jrosmirez94/Pedal-Multiefecto/Imagenes/PCB.jpeg

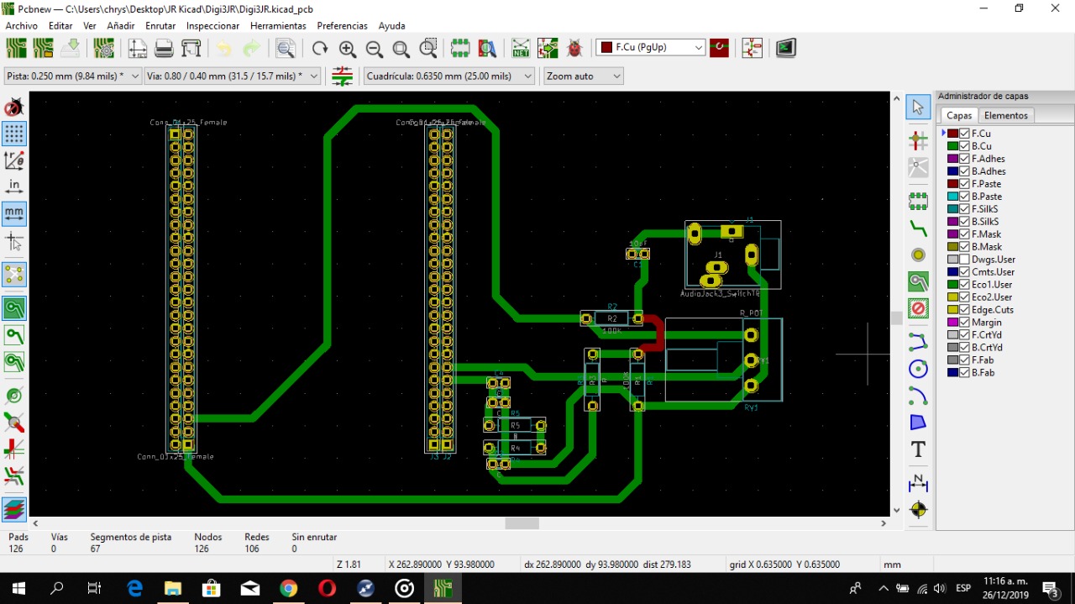
Imagenes/PCB.jpeg
