jrosmirez94/Pedal-Multiefecto/README.md

# Pedal-Multiefecto
Pedal Multiefecto para guitarra electrica (LoopBack, Delay, Fuzz y Wah-wah)
