jrosmirez94/Pedal-Multiefecto/Notas de clases/NOTAS CLASE 20200510.txt

CS43L22 DAC+amplificador de la discovery
que esta al lado del jack

este DAC es delta-sigma y el amplificador es clase D

Página 33 Control Port Operation
Datasheet

para mandar datos del micro al DAC, para enviarle los datos le tengo que indicar para quien es a traves del bus de datos, el adress fijo para comunicarme es "100101" 

La compilacion se basa en 3 pasos
	pre compiler
	compiler
	linker

-El pre compile hace un copy paste de los include agarra lo que hay en el ".h" y lo pega en el ".c"

-El compiler transforma cada ".c" en un ".o" 

-Linker toma todos los ".o" y genera el ejecutable

significa si que creas una variable global esa variable esta dentro de un ".o", si vos creas una variable con el mismo nombre en dos ".c" distintos, vas a tener dos .o distintos con la misma variable y el linker va a tirar un error para que eso no pase tenes que poner extern a una de esas variables, con eso le estas diciendo al linker que te LINKEE una variable con otra

EJEMPLO: extern I2C_HandleTypeDef hi2c1;

arranco a codear abajo de esto
|
|

/* USER CODE BEGIN 2 */

  /* USER CODE END 2 */

porque ya se inicializaron el clock 

HAL (hw abstration layer) es una libreria para que sea mas facil para el usuario codear

el hanlder es una instancia de una clase que tiene la configuracion del i2c

//HAL_GPIO_WritePin(LD6_GPIO_Port,LD6_Pin,1);
uint8_t data [2]; //necesito 2 bytes uno para el registro y otro para el dato que quiero poner en ese registro
data[0]=0x00; //registro
data[1]=0x99; //dato o valor
HAL_I2C_Master_Transmit(&hi2c1,0x94, data, 2, 50);
