jrosmirez94/Pedal-Multiefecto/Imagenes/Esquematico.jpeg

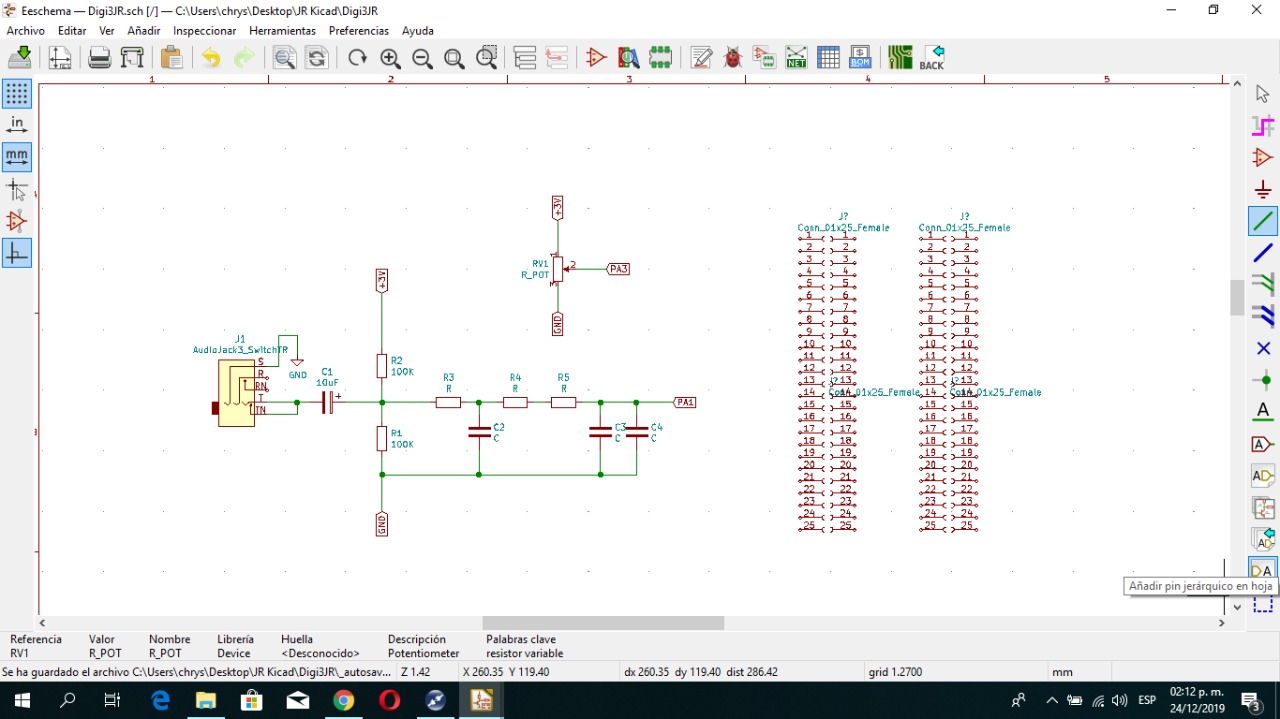
Imagenes/Esquematico.jpeg
