jrosmirez94/Pedal-Multiefecto/Imagenes/FSM effect - nivelacion y shift/FSM effect - nivelacion y shift/1 Nivelacion IN.jpg

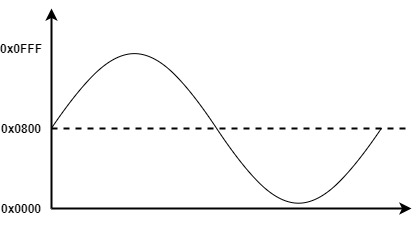
Imagenes/FSM effect - nivelacion y shift/FSM effect - nivelacion y shift/1 Nivelacion IN.jpg
