jrosmirez94/Pedal-Multiefecto/Imagenes/FSM effect - nivelacion y shift/FSM effect - nivelacion y shift/3 Shifteo nivelacion.jpg

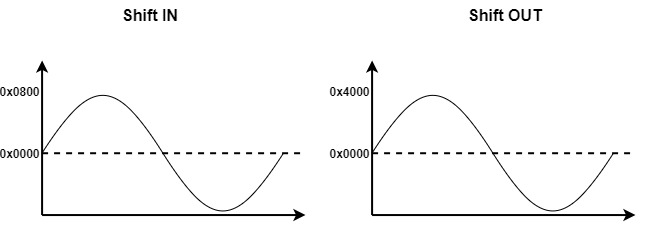
Imagenes/FSM effect - nivelacion y shift/FSM effect - nivelacion y shift/3 Shifteo nivelacion.jpg
