jrosmirez94/Pedal-Multiefecto/Pedal para guitarra - Jorge Rosmirez _v00/Pedal para guitarra - Jorge Rosmirez _v00.ioc

PD12.GPIO_Label=LD4 [Green Led]
PC12.Signal=I2S3_SD
PA14.GPIO_Label=SWCLK
PA6.GPIO_Label=SPI1_MISO [L3GD20_AS0/SDO]
PB6.GPIO_Label=Audio_SCL [CS43L22_SCL]
PC15-OSC32_OUT.GPIO_Label=PC15-OSC32_OUT
PD4.Signal=GPIO_Output
PB6.Signal=I2C1_SCL
PC7.Signal=I2S3_MCK
PC3.Signal=I2S2_SD
PE5.Signal=GPXTI5
PE1.Signal=GPXTI1
PE4.GPIO_Label=INT1 [LSM303DLHC_INT1]
PE2.Signal=GPIO_Input
PB9.Signal=I2C1_SDA
PD12.Signal=GPIO_Output
PA10.Signal=USB_OTG_FS_ID
PA4.GPIO_Label=I2S3_WS [CS43L22_LRCK]
PD15.Signal=GPIO_Output
PA9.GPIO_Label=VBUS_FS
PA11.GPIO_Label=OTG_FS_DM
PC0.Signal=GPIO_Output
PC14-OSC32_IN.Signal=RCC_OSC32_IN
PA0-WKUP.Signal=GPXTI0
PA9.Signal=USB_OTG_FS_VBUS
PB10.Signal=I2S2_CK
PA5.Signal=SPI1_SCK
PE1.GPIO_Label=MEMS_INT2 [L3GD20_INT2]
PC7.GPIO_Label=I2S3_MCK [CS43L22_MCLK]
PA4.Signal=I2S3_WS
PA5.GPIO_Label=SPI1_SCK [L3GD20_SC/SPC]
PE5.GPIO_Label=INT2 [LSM303DLHC_INT2]
PC12.GPIO_Label=I2S3_SD [CS43L22_SDIN]
PA11.Signal=USB_OTG_FS_DM
PE3.Signal=GPIO_Output
PC3.GPIO_Label=PDM_OUT [MP45DT02_DOUT]
Mcu.UserName=STM32F411VETx
PC10.Signal=I2S3_CK
PC0.GPIO_Label=OTG_FS_PowerSwitchOn
PD13.Signal=GPIO_Output
PA12.Signal=USB_OTG_FS_DP
PA10.GPIO_Label=OTG_FS_ID
PE4.Signal=GPXTI4
PD13.GPIO_Label=LD3 [Orange Led]
PA6.Signal=SPI1_MISO
PD5.GPIO_Label=OTG_FS_OverCurrent
PC14-OSC32_IN.GPIO_Label=PC14-OSC32_IN
PE2.GPIO_Label=DATA_Ready [LSM303DLHC_DRDY]
PA3.Signal=ADCx_IN3
PB3.GPIO_Label=SWO
PD15.GPIO_Label=LD6 [Blue Led]
PB9.GPIO_Label=Audio_SDA [CS43L22_SDA]
PC10.GPIO_Label=I2S3_SCK [CS43L22_SCLK]
PD5.Signal=GPIO_Input
PA12.GPIO_Label=OTG_FS_DP
PA13.Signal=SYS_JTMS-SWDIO
PB10.GPIO_Label=CLK_IN [MP45DT02_CLK]
PC15-OSC32_OUT.Signal=RCC_OSC32_OUT
PA1.Signal=ADCx_IN1
PD4.GPIO_Label=Audio_RST [CS43L22_RESET]
PD14.GPIO_Label=LD5 [Red Led]
PA13.GPIO_Label=SWDIO
PD14.Signal=GPIO_Output
PB3.Signal=SYS_JTDO-SWO
PA7.GPIO_Label=SPI1_MOSI [L3GD20_SDA/SDI/SDO]
PA14.Signal=SYS_JTCK-SWCLK
PE3.GPIO_Label=CS_I2C/SPI [L3GD20_CS_I2C/SPI]
PB12.Signal=I2S2_WS
PA7.Signal=SPI1_MOSI
