jrosmirez94/Pedal-Multiefecto/Pedal para guitarra - Jorge Rosmirez _v00/Src/audio.c

/******************************************************************************
 *  								INCLUDES
 ******************************************************************************/
// STM includes
#include "main.h"
#include "adc.h"
#include "i2c.h"
#include "i2s.h"
#include "stm32f4xx_it.h"
#include "arm_math.h"

// Project includes
#include "audio.h"
#include "CS43L22.h"

/******************************************************************************
 *  						GLOBAL VARIABLES DECLARATION
 ******************************************************************************/
DMA_FST_t transmit_ready = DMA_INIT;
q15_t * buffer_DMA = NULL; // puntero que apunta el vector con las muetras a ser procesadas

/******************************************************************************
 *  						LOCAL VARIABLES DECLARATION
 ******************************************************************************/
static q15_t   _dma_out   [DMA_HALF_SIZE * 2 * CHANNELS_OUT] = {0}; //salida
static q15_t   _dma_in    [DMA_HALF_SIZE * 2 * CHANNELS_IN] = {0}; //entrada
static q15_t   _dma_aux   [DMA_HALF_SIZE * 1 * CHANNELS_IN] = {0};
/******************************************************************************
 *  						GLOBAL FUNCTIONS DEFINITION
 ******************************************************************************/
void init_audio ()
{
	// Configura DAC
	CS43L22_init ();
	
	// Inicia Transmision de ADC y DAC (a traves de I2S) por DMA

	// DMA para mover del _dma_out al DAC
	HAL_I2S_Transmit_DMA (& hi2s3, (uint16_t *) _dma_out, DMA_HALF_SIZE * 2 * CHANNELS_OUT);
	HAL_Delay (1); // Must start I2S before ADC
	// DMA para mover del ADC al _dma_in
	HAL_ADC_Start_DMA (& hadc1, (uint32_t *) _dma_in, DMA_HALF_SIZE * 2 * CHANNELS_IN); // le doy el doble de capacidad con respecto al de salida porque tengo intercaladas las muetras del pote (es decir tengo 2 canales habilidados para el ADC)
}

/******************************************************************************
 *  						INTERRUPT HANDLERS
 ******************************************************************************/
// not use __disable_irq() and __enable_irq() to do critical stuffs
// put transmit_ready = HAL_TIMEOUT at finalize using buffer_DMA

//**ADC**//

void HAL_ADC_ConvHalfCpltCallback (ADC_HandleTypeDef * hadc)
{
	if (transmit_ready == DMA_LOGIC_BUSY) // indica que las muestras que tome del ADC no se procesaron, y esta tomando nuevas muestras y pisando información.
	{
	}
	else
	{			
		arm_shift_q15(&_dma_in[0],0,&_dma_aux[0],DMA_HALF_SIZE*CHANNELS_IN);
		buffer_DMA=&_dma_aux[0];
		transmit_ready = DMA_ADC_READY;		// hasta aca tengo la mitad del buffer lleno
	}
}

void HAL_ADC_ConvCpltCallback (ADC_HandleTypeDef * hadc)
{
	if (transmit_ready == DMA_LOGIC_BUSY)
	{
	}
	else
	{
		arm_shift_q15(&_dma_in[DMA_HALF_SIZE*CHANNELS_IN],0,&_dma_aux[0],DMA_HALF_SIZE*CHANNELS_IN);
		buffer_DMA=&_dma_aux[0];
		transmit_ready = DMA_ADC_READY; // hasta aca se completó la otra mitad
	}
}



//*** DAC ***//

void HAL_I2S_TxHalfCpltCallback (I2S_HandleTypeDef * hi2s)
{
	if (transmit_ready==DMA_LOGIC_BUSY)
	{
		memset (& _dma_out [0], 0, DMA_HALF_SIZE * CHANNELS_OUT); // si el buffer esta ocupado completas todo con 0´s para que a la salida no tenga ruido
		HAL_GPIO_WritePin(GPIOD,GPIO_PIN_13,GPIO_PIN_SET);
	}
	else
	{	
		arm_shift_q15(&_dma_aux[0],0,&_dma_out[0],DMA_HALF_SIZE*CHANNELS_OUT);
		buffer_DMA=NULL; // una vez que trasmitis no es valido este puntero
		transmit_ready = DMA_DAC_READY;
	}
}

void HAL_I2S_TxCpltCallback (I2S_HandleTypeDef * hi2s)
{
	if (transmit_ready == DMA_LOGIC_BUSY)
	{
		memset (& _dma_out [DMA_HALF_SIZE * CHANNELS_OUT], 0, DMA_HALF_SIZE * CHANNELS_OUT);
		HAL_GPIO_WritePin(GPIOD,GPIO_PIN_13,GPIO_PIN_SET);
	}
	else
	{
		arm_shift_q15(&_dma_aux[0],0,&_dma_out[DMA_HALF_SIZE*CHANNELS_OUT],DMA_HALF_SIZE*CHANNELS_OUT);
		buffer_DMA=NULL; 
		transmit_ready = DMA_DAC_READY;
	}
}


/******************************************************************************
 *  						LOCAL FUNCTIONS DEFINITION
******************************************************************************/
