jrosmirez94/Pedal-Multiefecto/Pedal para guitarra - Jorge Rosmirez _v00/Inc/wahwah.h

#ifndef WAHWAH_H_
#define WAHWAH_H_



#include "main.h"
#include "arm_math.h"


void wahwah_init (void);
void wahwah (q15_t *x, q15_t *out, int buff_size, uint32_t wah_vel);



#endif /* WAHWAH_H_ */
