jrosmirez94/Pedal-Multiefecto/(commit log)

2020-02-14 4 efectos andando... retocar algunos parametros
    [Pedal_Multiefecto_guitarraelectrica - v08 Debug.cfg]
2020-05-10 configuracion del DAC por I2C
2020-05-24 configuracion de timer 3, no interrumpe
2020-05-31 configuracion ADC con DMA disparado por timer
2020-06-07 configuracion maquina de estado DMA
2020-06-26 maquina de estados de efectos
2020-06-28 programacion de loopback
2020-07-05 Funciona el DAC, con crosstalk
2020-07-10 version 4 informe, hasta el punto 4 hecho inclusive
2020-07-19 funciona ADC, funciona loopback, de un canal se escucha mas bajo y con glitch, comenzamos el eco no esta testeado, consumo excesivo de memoria optimizarlo
    [Pedal para guitarra - Jorge Rosmirez _v00.ioc, audio.c, audio.h, main_funcs.c]
2020-07-24 Se cambio a formato q31, se escucha sin glitch (hasta nuevo aviso) --> Falta codear los efectos, Eco en adelante
    [Pedal para guitarra - Jorge Rosmirez _v00.ioc, audio.c, audio.h, main_funcs.c]
2020-07-26 cambiamos buffers a q15 y no hay problemas de memoria | anda el eco |revisar HW pote |seguir con el fuzz
    [Pedal para guitarra - Jorge Rosmirez _v00.ioc, audio.c, audio.h, fuzz.c, main_funcs.c]
2020-08-28 se codio las celdas biquad en 2q14 hay que probar que parametros funcionan
2020-08-30 Se escucha un wah wah pitido, pero no wawea el audio inyectado
2020-09-06 CONCLUSION PITIDO: aplica filtro a ruido blanco | Esta filtrando | esta variando la amplitud solo cuando inyecto un tono
2020-09-11 prueba de usuario
2020-09-13 fuzz estaria falta agregar pote | corregir el wah wah
2020-09-20 funciona fuzz con pote | wah wah con pote no se rompe | resta probar wahwah con señal que wahweeh
2020-09-26 Added diagrama de estados efectos.drawio
2020-09-26 Update diagrama de estados efectos.drawio
2020-09-26 imagenes actualizadas | se añadio tabla de imagenes | falta conclusiones y software adicional | mejorar algunas redaciones o enriquecerlas
2020-09-27 FALTA graficos main loop start y end con redaccion | falta matlab con hojas de dato texas | Falta conclusiones | Se realizo FSM DMA, Wahwah
2020-09-28 Added diagrama de estados efectos.jpg
