jrosmirez94/Pedal-Multiefecto/(notices)

Notices in the files:
Pedal_Multiefecto_guitarraelectrica - v08/Inc/main.h:
© Copyright (c) 2020 STMicroelectronics.
All rights reserved.
This software component is licensed by ST under Ultimate Liberty license
(C) COPYRIGHT STMicroelectronics *****END OF FILE
